OpenShock/Hardware/README.md

# OpenShock-Hardware
KiCAD files for PCBs for transmitters and other hardware for [OpenShock](https://github.com/OpenShock/Firmware)

2024-05-16--23-23-04-kicad
