OpenShock/Hardware/Core v2/Case/STL/Core V2 Half Bottom.stl

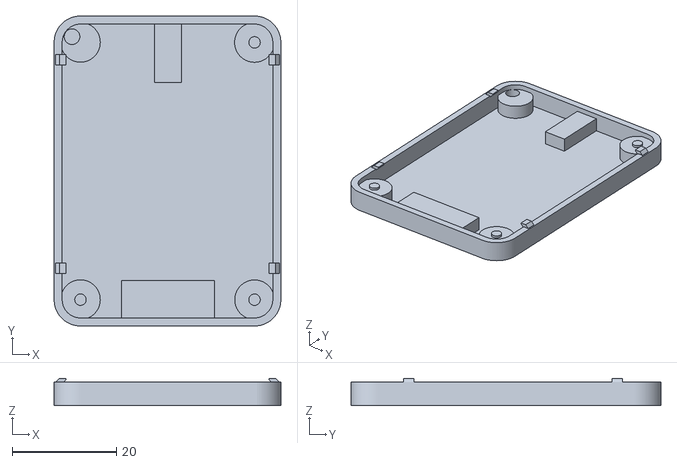
[picture p2: CAD file, 2024-05-17]
Core v2/Case/STL/Core V2 Half Bottom.stl
43.5 x 59.5 x 5.21
