OpenShock/Hardware/Core v2/Case/3MF/Core V2 Top Sans Estop.3mf

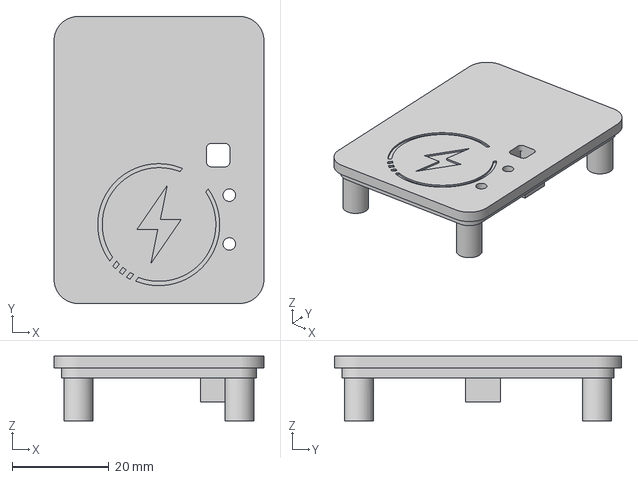
[picture p3: CAD file, 2024-05-17]
Core v2/Case/3MF/Core V2 Top Sans Estop.3mf
43.5 x 59.5 x 13.4 mm
