OpenShock/Hardware/Core v2/Case/3MF/Core V2 EStop.3mf

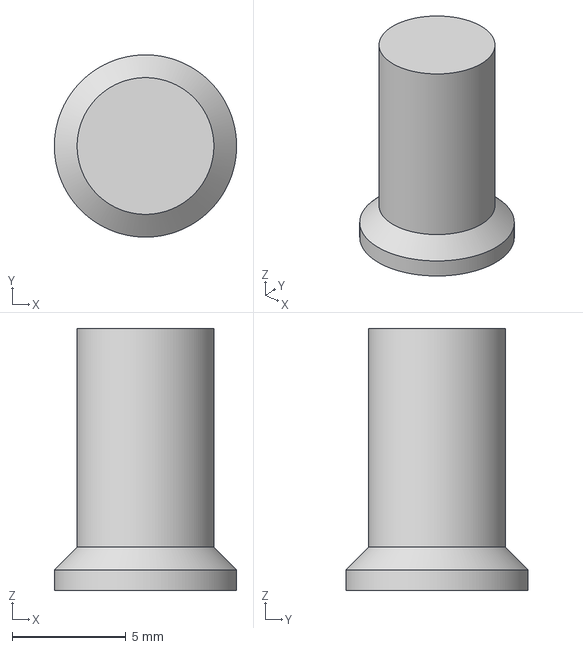
[picture p4: CAD file, 2024-05-17]
Core v2/Case/3MF/Core V2 EStop.3mf
8.00 x 8.00 x 11.5 mm
