OpenShock/Hardware/Core v2/Case/3MF/Core V2 Bottom.3mf

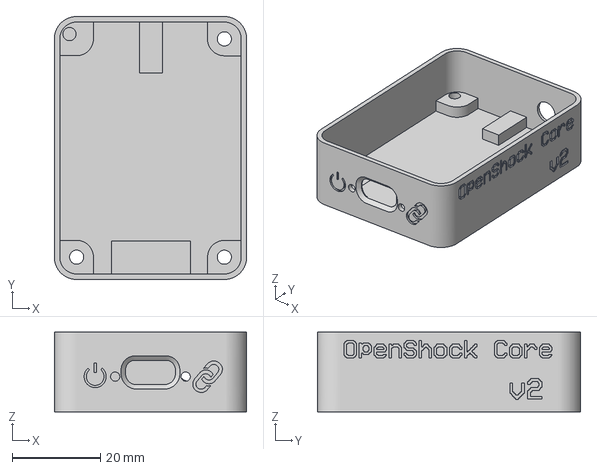
[picture p5: CAD file, 2024-05-17]
Core v2/Case/3MF/Core V2 Bottom.3mf
43.5 x 59.5 x 18.0 mm
