OpenShock/Hardware/Core/Case/3MF/Core V1 Button.3mf

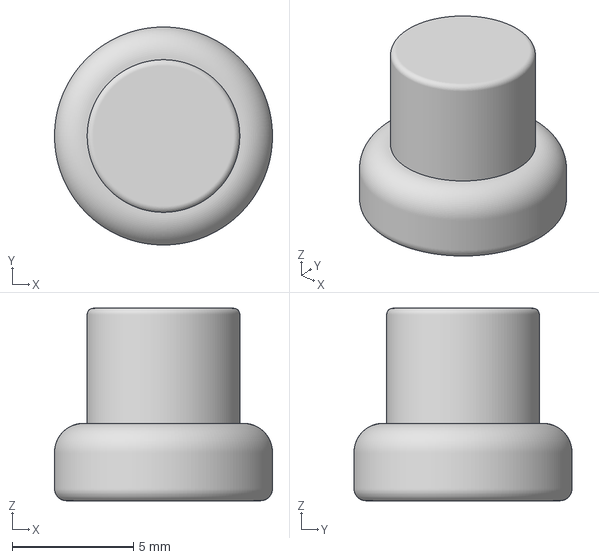
[picture p7: CAD file, 2024-05-17, an earlier design]
Core/Case/3MF/Core V1 Button.3mf
9.00 x 9.00 x 7.95 mm
