OpenShock/Hardware/Core/Case/3MF/Core V1 Top.3mf

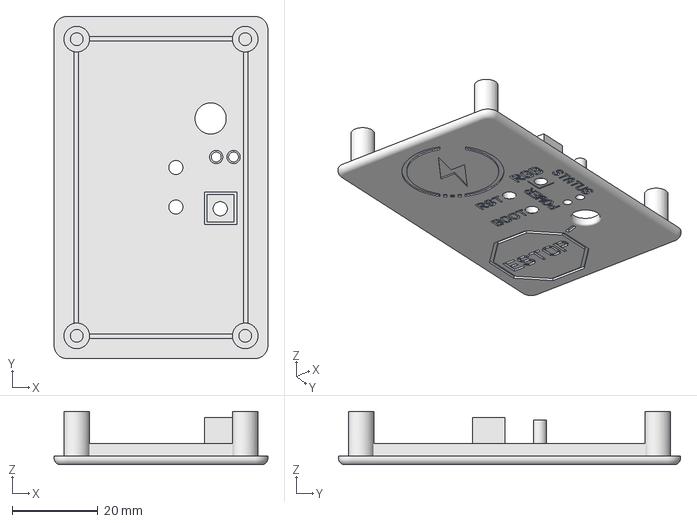
[picture p8: CAD file, 2024-05-17, an earlier design]
Core/Case/3MF/Core V1 Top.3mf
50.0 x 80.0 x 12.5 mm
