OpenShock/Hardware/(list of files, cad)

Other CAD files:
Core v2/Case/3MF/Core V2 Dev Bottom.3mf
Core v2/Case/STL/Core V2 Bottom.stl
Core v2/Case/STL/Core V2 EStop.stl
Core v2/Case/STL/Core V2 Top Sans Estop.stl
Core v2/Case/STL/Core V2 Top.stl
Core/Case/STL/Core V1 Bottom.stl
Core/Case/STL/Core V1 Button.stl
Core/Case/STL/Core V1 Top.stl
