OpenShock/Hardware/Core v2/OpenShock-CoreV2.2-sch.pdf

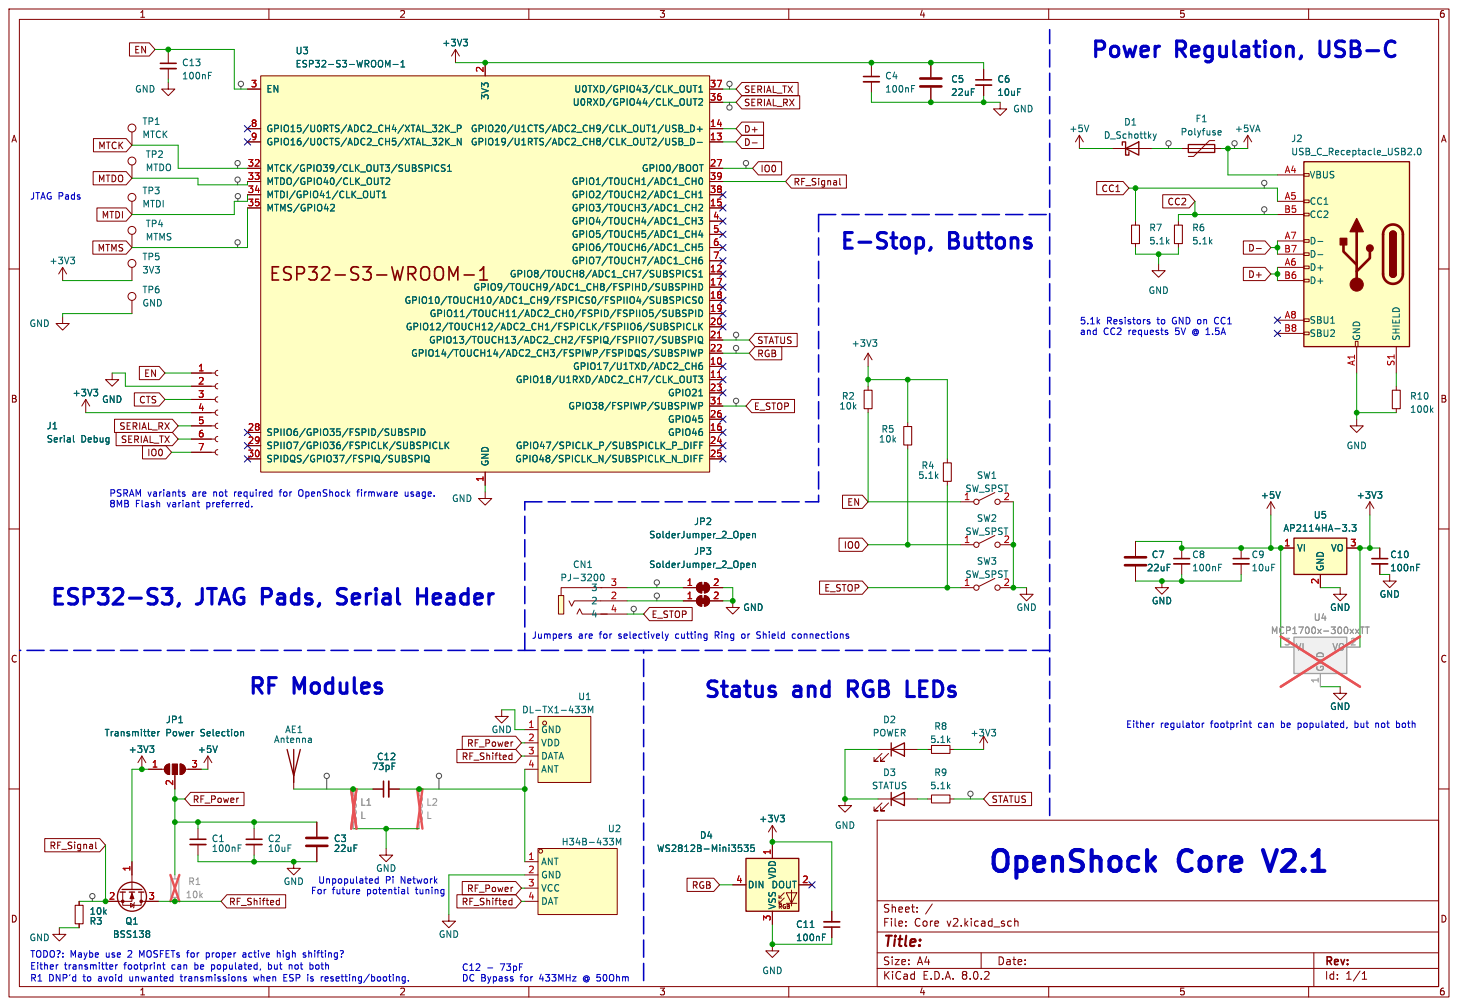
[picture p9: page 1]

2 GPIO12/TOUCH12/ADC2_CH1/FSPICLK/FSPIIO6/SUBSPICLK 20 GPIO13/TOUCH13/ADC2_CH2/FSPIQ/FSPIIO7/SUBSPIQ 21 GPIO14/TOUCH14/ADC2_CH3/FSPIWP/FSPIDQS/SUBSPIWP 22 GPIO21 23 GPIO47/SPICLK_P/SUBSPICLK_P_DIFF 24 GPIO48/SPICLK_N/SUBSPICLK_N_DIFF 25 GPIO45 26 GPIO0/BOOT 27 SPIIO6/GPIO35/FSPID/SUBSPID 28 SPIIO7/GPIO36/FSPICLK/SUBSPICLK 29 EN 3 SPIDQS/GPIO37/FSPIQ/SUBSPIQ 30 GPIO38/FSPIWP/SUBSPIWP 31 MTCK/GPIO39/CLK_OUT3/SUBSPICS1 32 MTDO/GPIO40/CLK_OUT2 33 MTDI/GPIO41/CLK_OUT1 34 MTMS/GPIO42 35 U0RXD/GPIO44/CLK_OUT2 36 U0TXD/GPIO43/CLK_OUT1 37 GPIO2/TOUCH2/ADC1_CH1 38 GPIO1/TOUCH1/ADC1_CH0 39 GPIO4/TOUCH4/ADC1_CH3 4 GPIO5/TOUCH5/ADC1_CH4 5 GPIO6/TOUCH6/ADC1_CH5 6 GPIO7/TOUCH7/ADC1_CH6 7 GPIO15/U0RTS/ADC2_CH4/XTAL_32K_P 8 GPIO16/U0CTS/ADC2_CH5/XTAL_32K_N 9 +3V3

2 GPIO12/TOUCH12/ADC2_CH1/FSPICLK/FSPIIO6/SUBSPICLK 20 GPIO13/TOUCH13/ADC2_CH2/FSPIQ/FSPIIO7/SUBSPIQ 21 GPIO14/TOUCH14/ADC2_CH3/FSPIWP/FSPIDQS/SUBSPIWP 22 GPIO21 23 GPIO47/SPICLK_P/SUBSPICLK_P_DIFF 24 GPIO48/SPICLK_N/SUBSPICLK_N_DIFF 25 GPIO45 26 GPIO0/BOOT 27 SPIIO6/GPIO35/FSPID/SUBSPID 28 SPIIO7/GPIO36/FSPICLK/SUBSPICLK 29 EN 3 SPIDQS/GPIO37/FSPIQ/SUBSPIQ 30 GPIO38/FSPIWP/SUBSPIWP 31 MTCK/GPIO39/CLK_OUT3/SUBSPICS1 32 MTDO/GPIO40/CLK_OUT2 33 MTDI/GPIO41/CLK_OUT1 34 MTMS/GPIO42 35 U0RXD/GPIO44/CLK_OUT2 36 U0TXD/GPIO43/CLK_OUT1 37 GPIO2/TOUCH2/ADC1_CH1 38 GPIO1/TOUCH1/ADC1_CH0 39 GPIO4/TOUCH4/ADC1_CH3 4 GPIO5/TOUCH5/ADC1_CH4 5 GPIO6/TOUCH6/ADC1_CH5 6 GPIO7/TOUCH7/ADC1_CH6 7 GPIO15/U0RTS/ADC2_CH4/XTAL_32K_P 8 GPIO16/U0CTS/ADC2_CH5/XTAL_32K_N 9 U3ESP32-S3-WROOM-1

1 GPIO17/U1TXD/ADC2_CH6 10 GPIO18/U1RXD/ADC2_CH7/CLK_OUT3 11 GPIO8/TOUCH8/ADC1_CH7/SUBSPICS1 12 GPIO19/U1RTS/ADC2_CH8/CLK_OUT2/USB_D- 13 GPIO20/U1CTS/ADC2_CH9/CLK_OUT1/USB_D+ 14 GPIO3/TOUCH3/ADC1_CH2 15 GPIO46 16 GPIO9/TOUCH9/ADC1_CH8/FSPIHD/SUBSPIHD 17 GPIO10/TOUCH10/ADC1_CH9/FSPICS0/FSPIIO4/SUBSPICS0 18 GPIO11/TOUCH11/ADC2_CH0/FSPID/FSPIIO5/SUBSPID 19 3V3

1 VO 2 VI 3 GND GND +3V3

Id: 1/1 Title: File: Core v2.kicad_sch Sheet: /
