OpenShock/Hardware/Core/OpenShock-sch.pdf

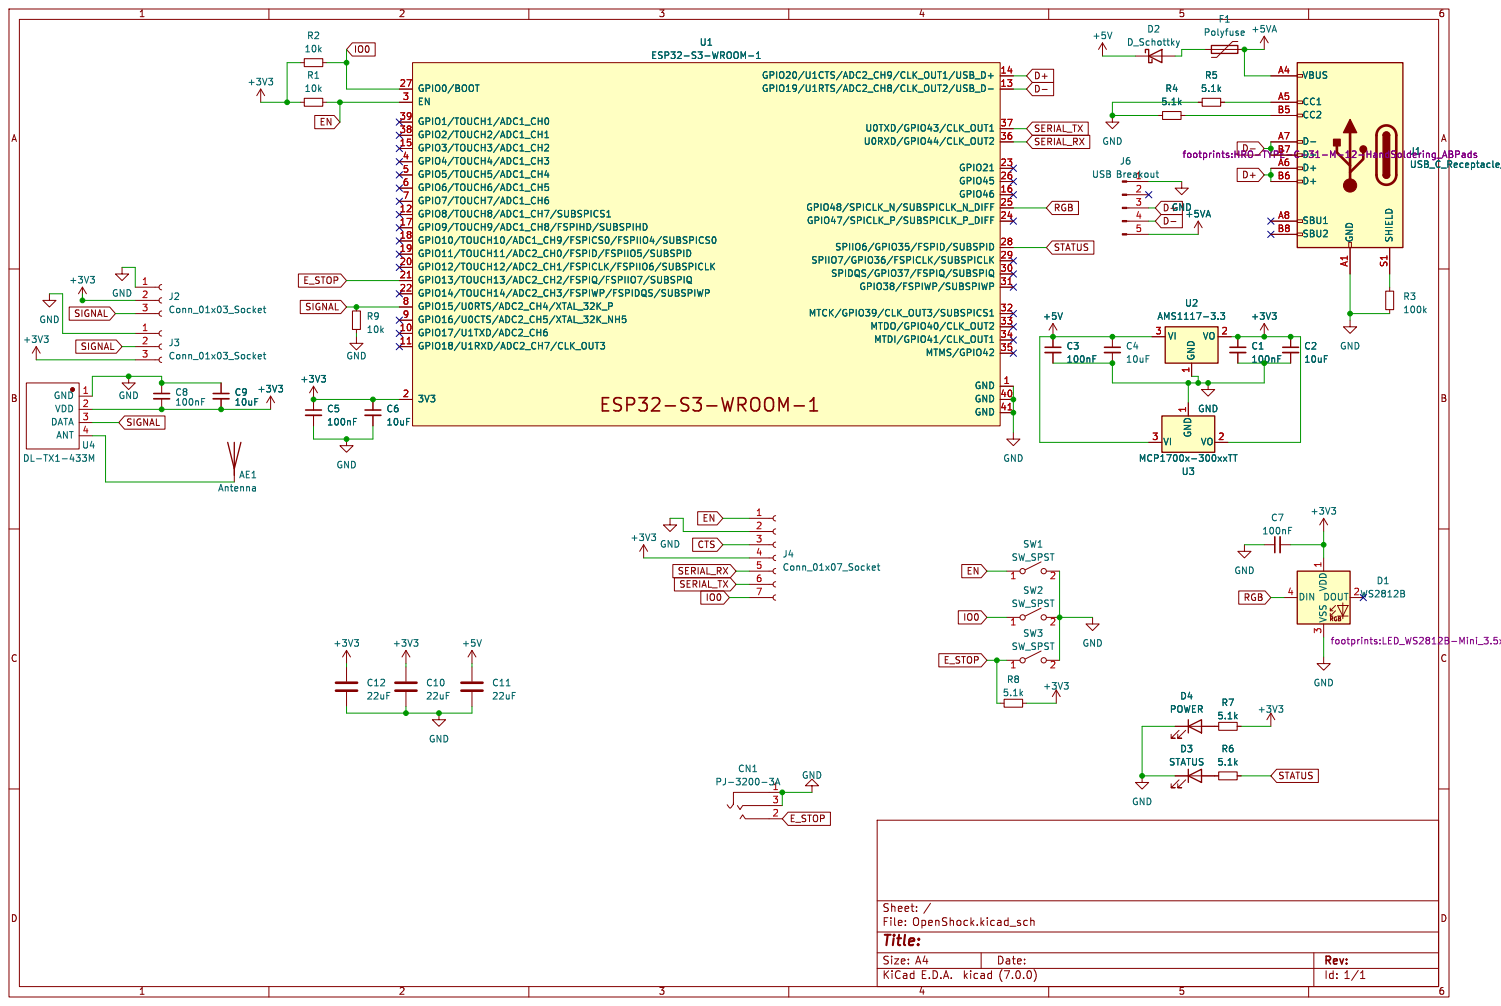
[picture p10: page 1]

Id: 1/1 Title: File: OpenShock.kicad_sch Sheet: / 1
