OpenShock/Hardware/Core v2/Core v2.kicad_pcb

## KiCad design Core v2/Core v2.kicad_pcb (2024-05-17)

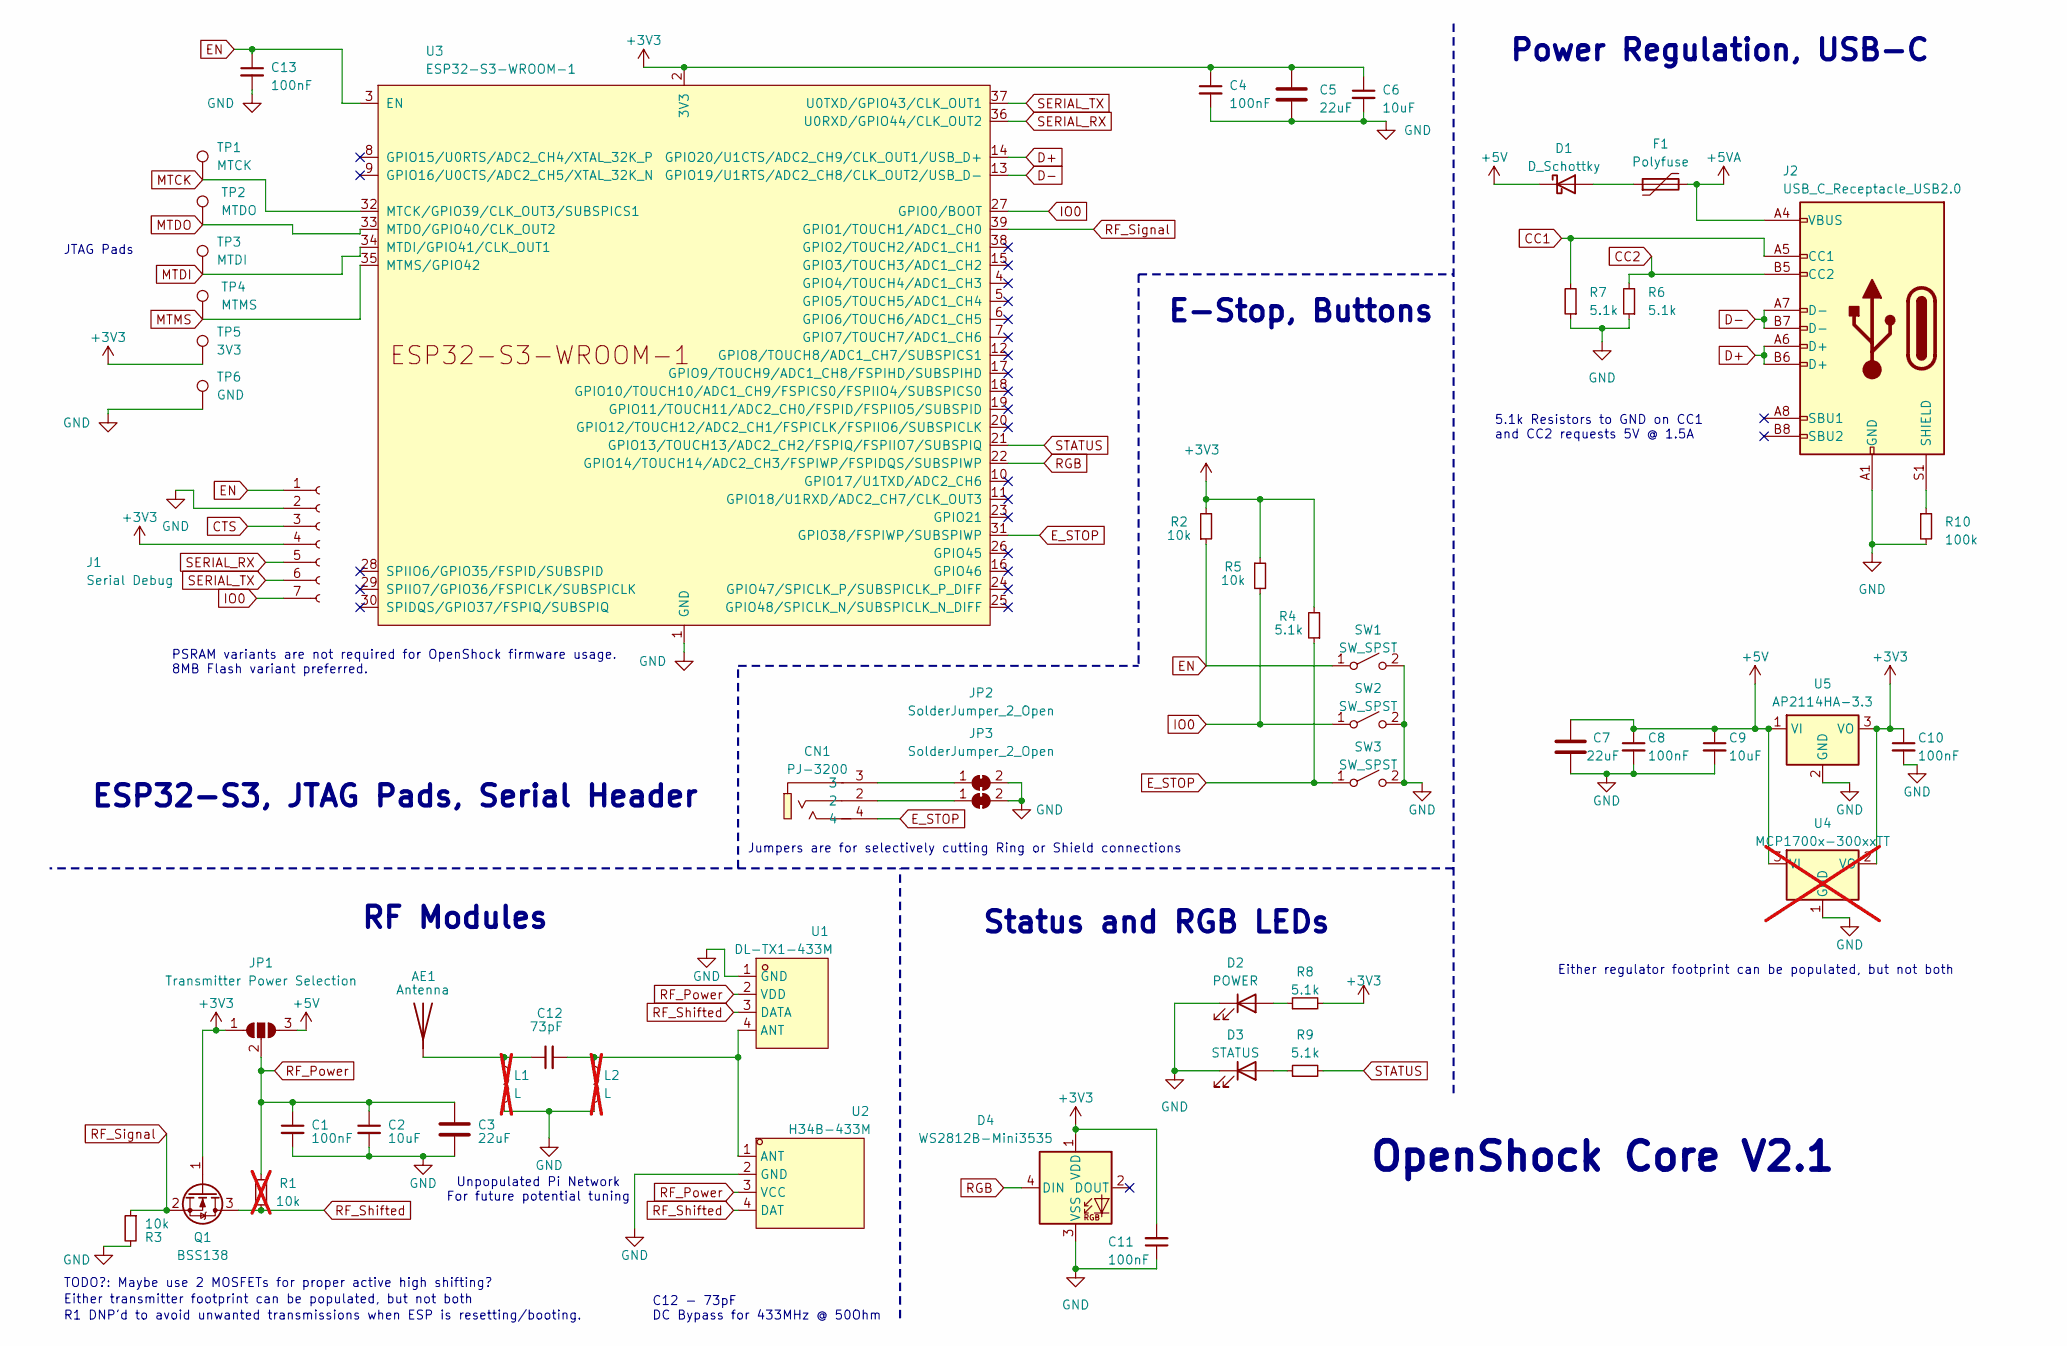
[picture p11: schematic Core v2.kicad_sch]

Parts:
AE1: Antenna; Pin_D1.0mm_L10.0mm
C1, C4, C8, C10, C11, C13: 100nF; C_0603_1608Metric_Pad1.08x0.95mm_HandSolder
C2, C6, C9: 10uF; C_0603_1608Metric_Pad1.08x0.95mm_HandSolder
C3, C5, C7: 22uF; C_0805_2012Metric_Pad1.18x1.45mm_HandSolder
C12: 73pF; C_0603_1608Metric_Pad1.08x0.95mm_HandSolder
CN1: PJ-3200; AUDIO-TH_PJ-3200; LCSC Part C2689690
D1: D_Schottky; D_SOD-123
D2: POWER; LED_0603_1608Metric_Pad1.05x0.95mm_HandSolder
D3: STATUS; LED_0603_1608Metric_Pad1.05x0.95mm_HandSolder
D4: WS2812B-Mini3535; LED_WS2812B-Mini_3.5x3.5mm_P1.75mm
F1: Polyfuse; Fuse_1206_3216Metric_Pad1.42x1.75mm_HandSolder
J1: Serial Debug; 1X07_LOCK
J2: USB_C_Receptacle_USB2.0; HRO-TYPE-C-31-M-12-HandSoldering_ABPads
JP1: Transmitter Power Selection; SolderJumper-3_P1.3mm_Open_RoundedPad1.0x1.5mm
JP2, JP3: SolderJumper_2_Open; SolderJumper-2_P1.3mm_Bridged_RoundedPad1.0x1.5mm
L1, L2: L; L_0603_1608Metric_Pad1.05x0.95mm_HandSolder; not fitted
Q1: BSS138; SOT-23
R1: 10k; R_0603_1608Metric_Pad0.98x0.95mm_HandSolder; not fitted
R2, R3, R5: 10k; R_0603_1608Metric_Pad0.98x0.95mm_HandSolder
R4, R6, R7, R8, R9: 5.1k; R_0603_1608Metric_Pad0.98x0.95mm_HandSolder
R10: 100k; R_0603_1608Metric_Pad0.98x0.95mm_HandSolder
SW1, SW2, SW3: SW_SPST; SW_PUSH_6mm_customized
TP1: MTCK; TestPoint_Pad_1.0x1.0mm
TP2: MTDO; TestPoint_Pad_1.0x1.0mm
TP3: MTDI; TestPoint_Pad_1.0x1.0mm
TP4: MTMS; TestPoint_Pad_1.0x1.0mm
TP5: 3V3; TestPoint_Pad_1.0x1.0mm
TP6: GND; TestPoint_Pad_1.0x1.0mm
U1: DL-TX1-433M; WIELM-TH_DL-TX1-433M; LCSC Part C381160
U2: H34B-433M; WIRELM-TH_H34S-433M; LCSC Part C89460
U3: ESP32-S3-WROOM-1
U4: MCP1700x-300xxTT; SOT-23_Handsoldering; not fitted
U5: AP2114HA-3.3; SOT-223-3_TabPin2

Connections:
+3V3: C4.1, C5.1, C6.1, C10.1, C11.2, D4.1 (VDD), J1.4, JP1.1 (A), Q1.1 (G), R2.2, R4.2, R5.1, R8.2, TP5.1, U3.2 (3V3), U4.2 (VO), U5.3 (VO)
+5V: C7.1, C8.1, C9.1, D1.1 (K), JP1.3 (B), U4.3 (VI), U5.1 (VI)
+5VA: F1.2, J2.A4 (VBUS), J2.A9 (VBUS), J2.B4 (VBUS), J2.B9 (VBUS)
CC1: J2.A5 (CC1), R7.2
CC2: J2.B5 (CC2), R6.2
CTS: J1.3
D+: J2.A6 (D+), J2.B6 (D+), U3.14 (GPIO20/U1CTS/ADC2_CH9/CLK_OUT1/USB_D+)
D-: J2.A7 (D-), J2.B7 (D-), U3.13 (GPIO19/U1RTS/ADC2_CH8/CLK_OUT2/USB_D-)
EN: C13.1, J1.1, R2.1, SW1.1 (A), U3.3 (EN)
E_STOP: CN1.4, R4.1, SW3.1 (A), U3.31 (GPIO38/FSPIWP/SUBSPIWP)
GND: C1.2, C2.2, C3.2, C4.2, C5.2, C6.2, C7.2, C8.2, C9.2, C10.2, C11.1, C13.2, D2.1 (K), D3.1 (K), D4.3 (VSS), J1.2, J2.A1 (GND), J2.A12 (GND), J2.B1 (GND), J2.B12 (GND), JP2.2 (B), JP3.2 (B), L1.2, L2.2, R3.2, R6.1, R7.1, R10.2, SW1.2 (B), SW2.2 (B), SW3.2 (B), TP6.1, U1.1 (GND), U2.2 (GND), U3.1 (GND), U3.40 (GND), U3.41 (GND), U4.1 (GND), U5.2 (GND)
IO0: J1.7, R5.2, SW2.1 (A), U3.27 (GPIO0/BOOT)
MTCK: TP1.1, U3.32 (MTCK/GPIO39/CLK_OUT3/SUBSPICS1)
MTDI: TP3.1, U3.34 (MTDI/GPIO41/CLK_OUT1)
MTDO: TP2.1, U3.33 (MTDO/GPIO40/CLK_OUT2)
MTMS: TP4.1, U3.35 (MTMS/GPIO42)
unnamed: AE1.1 (A), C12.1, L1.1
unnamed: D1.2 (A), F1.1
unnamed: D2.2 (A), R8.1
unnamed: D3.2 (A), R9.1
unnamed: J2.S1 (SHIELD), R10.1
unnamed: CN1.3, JP2.1 (A)
unnamed: CN1.2, JP3.1 (A)
unnamed: C12.2, L2.1, U1.4 (ANT), U2.1 (ANT)
RF_Power: C1.1, C2.1, C3.1, JP1.2 (C), R1.1, U1.2 (VDD), U2.3 (VCC)
RF_Shifted: Q1.3 (D), R1.2, U1.3 (DATA), U2.4 (DAT)
RF_Signal: Q1.2 (S), R3.1, U3.39 (GPIO1/TOUCH1/ADC1_CH0)
RGB: D4.4 (DIN), U3.22 (GPIO14/TOUCH14/ADC2_CH3/FSPIWP/FSPIDQS/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)
SERIAL_RX: J1.5, U3.36 (U0RXD/GPIO44/CLK_OUT2)
SERIAL_TX: J1.6, U3.37 (U0TXD/GPIO43/CLK_OUT1)
STATUS: R9.2, U3.21 (GPIO13/TOUCH13/ADC2_CH2/FSPIQ/FSPIIO7/S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)

Notes on the sheet:
RF Modules
JTAG Pads
PSRAM variants are not required for OpenShock firmware usage. 8MB Flash variant preferred.
OpenShock Core V2.1
E-Stop, Buttons
Power Regulation, USB-C
5.1k Resistors to GND on CC1 and CC2 requests 5V @ 1.5A
Unpopulated Pi Network For future potential tuning
R1 DNP'd to avoid unwanted transmissions when ESP is resetting/booting.
C12 - 73pF DC Bypass for 433MHz @ 50Ohm
Jumpers are for selectively cutting Ring or Shield connections
Status and RGB LEDs
Either transmitter footprint can be populated, but not both
Either regulator footprint can be populated, but not both
TODO?: Maybe use 2 MOSFETs for proper active high shifting?
ESP32-S3, JTAG Pads, Serial Header

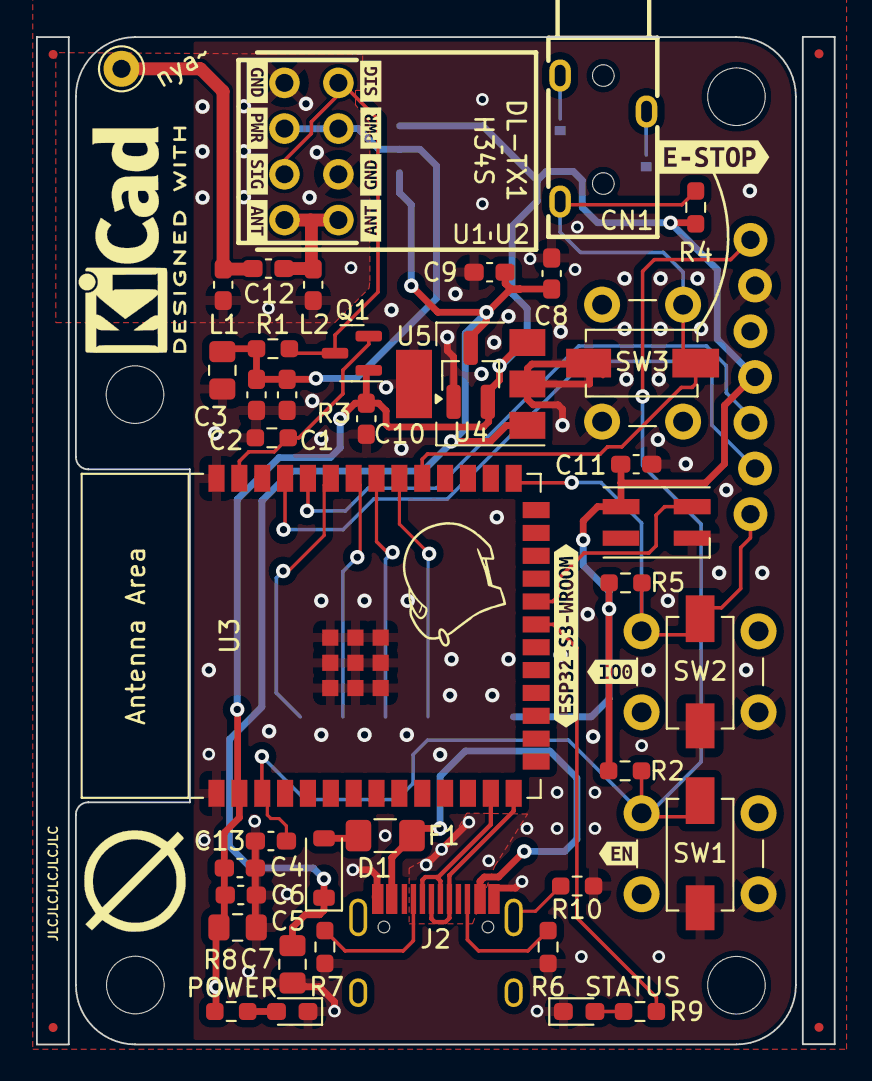
[picture p12: board Core v2.kicad_pcb from above]

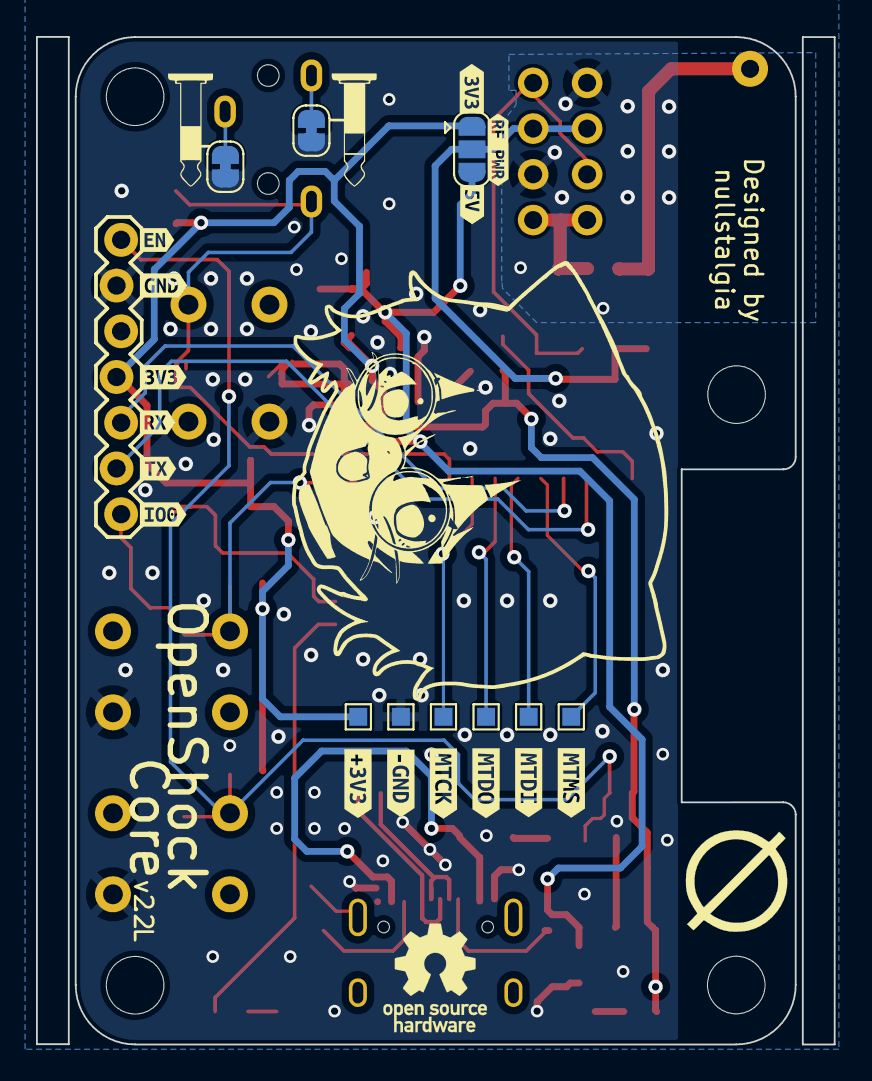
[picture p13: board Core v2.kicad_pcb from below]

Board: 2 copper layers, 40.0 x 56.0 mm, 83 parts (25 on the bottom side), 30 nets.

Other parts of the board:
FID1, FID1#2, FID4, FID4#2: Fiducial; Fiducial_0.5mm_Mask1mm
kibuzzard-63FC1B9A: G***; kibuzzard-63FC1B9A
kibuzzard-63FC1BA4: G***; kibuzzard-63FC1BA4
kibuzzard-63FC1BB3: G***; kibuzzard-63FC1BB3
kibuzzard-65FD518D: G***; kibuzzard-65FD518D
kibuzzard-65FD5191: G***; kibuzzard-65FD5191
kibuzzard-658A25BD: G***; kibuzzard-658A25BD
kibuzzard-658A26D4: G***; kibuzzard-658A26D4
kibuzzard-658A26D7: G***; kibuzzard-658A26D7
kibuzzard-658A26DB: G***; kibuzzard-658A26DB
kibuzzard-658A27EA: G***; kibuzzard-658A27EA
kibuzzard-658A42A3, kibuzzard-658A42A3#2: G***; kibuzzard-658A42A3
kibuzzard-658A42A8, kibuzzard-658A42A8#2: G***; kibuzzard-658A42A8
kibuzzard-658A42AC, kibuzzard-658A42AC#2: G***; kibuzzard-658A42AC
kibuzzard-658A264C: G***; kibuzzard-658A264C
kibuzzard-658A265D: G***; kibuzzard-658A265D
kibuzzard-658A269D: G***; kibuzzard-658A269D
kibuzzard-658A429F, kibuzzard-658A429F#2: G***; kibuzzard-658A429F
kibuzzard-658A779F: G***; kibuzzard-658A779F
kibuzzard-658A2647: G***; kibuzzard-658A2647
kibuzzard-658A2652: G***; kibuzzard-658A2652
kibuzzard-658A2659: G***; kibuzzard-658A2659
kibuzzard-658A2661: G***; kibuzzard-658A2661
kibuzzard-658A4835: G***; kibuzzard-658A4835
