OpenShock/Hardware/Core/OpenShock.kicad_pcb

## KiCad design Core/OpenShock.kicad_pcb (2023-12-02, an earlier design)

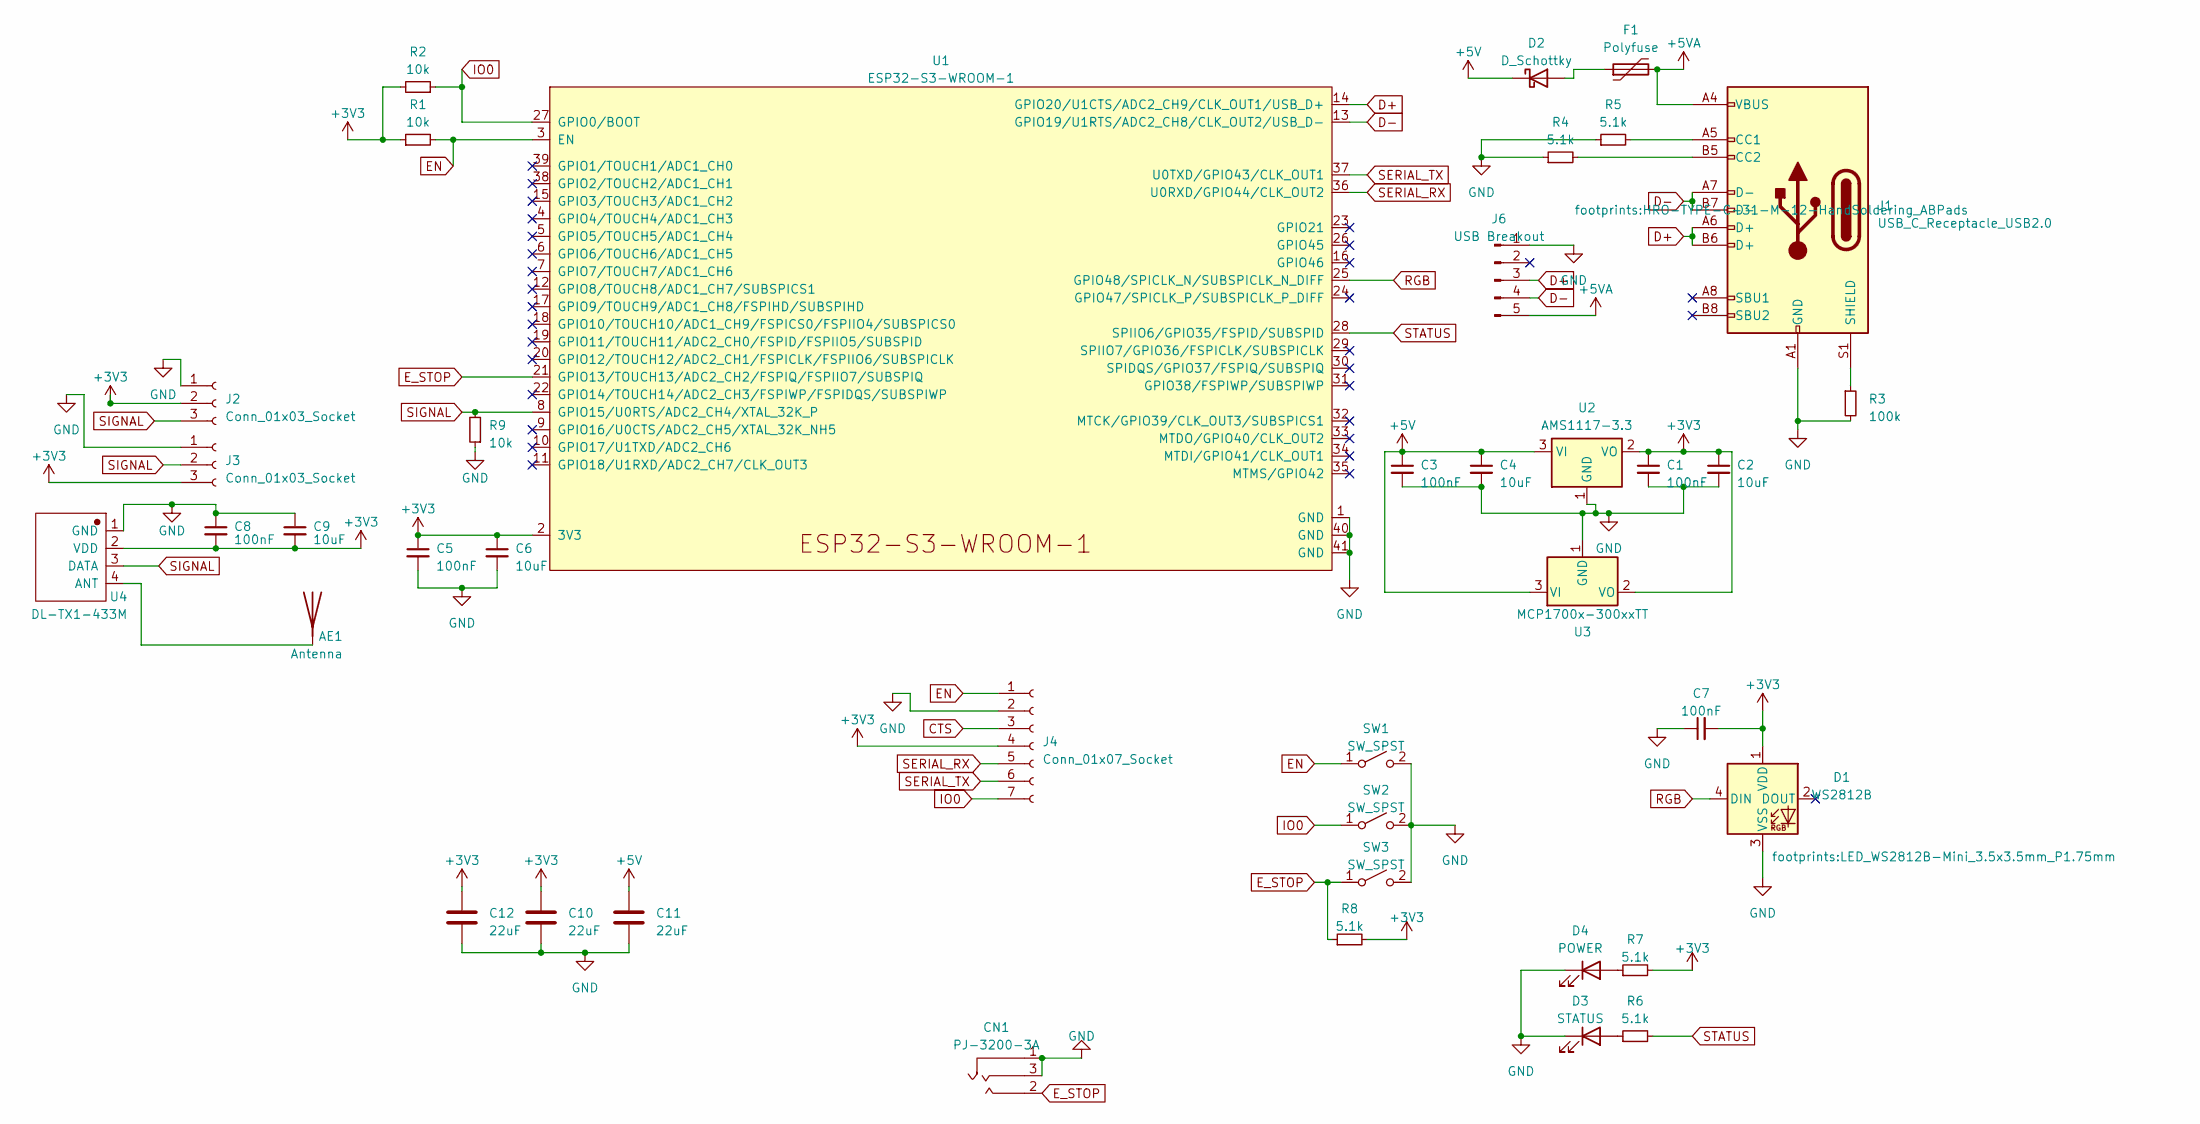
[picture p14: schematic OpenShock.kicad_sch]

Parts:
AE1: Antenna; PinHeader_1x01_P2.54mm_Vertical
C1, C3, C5, C7, C8: 100nF; C_0603_1608Metric_Pad1.08x0.95mm_HandSolder
C2, C4, C6, C9: 10uF; C_0603_1608Metric_Pad1.08x0.95mm_HandSolder
C10, C11, C12: 22uF; C_0805_2012Metric_Pad1.18x1.45mm_HandSolder
CN1: PJ-3200-3A; AUDIO-TH_PJ-3200-3A
D1: WS2812B; LED_WS2812B-Mini_3.5x3.5mm_P1.75mm
D2: D_Schottky; D_SOD-123
D3: STATUS; LED_0603_1608Metric_Pad1.05x0.95mm_HandSolder
D4: POWER; LED_0603_1608Metric_Pad1.05x0.95mm_HandSolder
F1: Polyfuse; Fuse_1206_3216Metric_Pad1.42x1.75mm_HandSolder
J1: USB_C_Receptacle_USB2.0; HRO-TYPE-C-31-M-12-HandSoldering_ABPads
J2, J3: Conn_01x03_Socket; PinSocket_1x03_P2.54mm_Vertical
J4: Conn_01x07_Socket; 1X07_LOCK
J6: USB Breakout; PinSocket_1x05_P2.54mm_Vertical
R1, R2, R9: 10k; R_0603_1608Metric_Pad0.98x0.95mm_HandSolder
R3: 100k; R_0603_1608Metric_Pad0.98x0.95mm_HandSolder
R4, R5, R6, R7, R8: 5.1k; R_0603_1608Metric_Pad0.98x0.95mm_HandSolder
SW1, SW2: SW_SPST; SW_PUSH_6mm_customized
SW3: SW_SPST; SW_PUSH-12mm
U1: ESP32-S3-WROOM-1
U2: AMS1117-3.3; SOT-223-3_TabPin2
U3: MCP1700x-300xxTT; SOT-23_Handsoldering
U4: DL-TX1-433M; WIELM-TH_DL-TX1-433M

Connections:
+3V3: C1.1, C2.1, C5.1, C6.1, C7.2, C8.2, C9.2, C10.1, C12.1, D1.1 (VDD), J2.2, J3.3, J4.4, R1.1, R2.2, R7.2, R8.2, U1.2 (3V3), U2.2 (VO), U3.2 (VO), U4.2 (VDD)
+5V: C3.1, C4.1, C11.1, D2.1 (K), U2.3 (VI), U3.3 (VI)
+5VA: F1.2, J1.A4 (VBUS), J1.A9 (VBUS), J1.B4 (VBUS), J1.B9 (VBUS), J6.5
CTS: J4.3
D+: J1.A6 (D+), J1.B6 (D+), J6.3, U1.14 (GPIO20/U1CTS/ADC2_CH9/CLK_OUT1/USB_D+)
D-: J1.A7 (D-), J1.B7 (D-), J6.4, U1.13 (GPIO19/U1RTS/ADC2_CH8/CLK_OUT2/USB_D-)
EN: J4.1, R1.2, SW1.1 (A), U1.3 (EN)
E_STOP: CN1.2, R8.1, SW3.1 (A), U1.21 (GPIO13/TOUCH13/ADC2_CH2/FSPIQ/FSPIIO7/S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)
GND: C1.2, C2.2, C3.2, C4.2, C5.2, C6.2, C7.1, C8.1, C9.1, C10.2, C11.2, C12.2, CN1.1, CN1.3, D1.3 (VSS), D3.1 (K), D4.1 (K), J1.A1 (GND), J1.A12 (GND), J1.B1 (GND), J1.B12 (GND), J2.1, J3.1, J4.2, J6.1, R3.2, R4.1, R5.1, R9.1, SW1.2 (B), SW2.2 (B), SW3.2 (B), U1.1 (GND), U1.40 (GND), U1.41 (GND), U2.1 (GND), U3.1 (GND), U4.1 (GND)
IO0: J4.7, R2.1, SW2.1 (A), U1.27 (GPIO0/BOOT)
unnamed: AE1.1 (A), U4.4 (ANT)
unnamed: D2.2 (A), F1.1
unnamed: D3.2 (A), R6.1
unnamed: D4.2 (A), R7.1
unnamed: J1.A5 (CC1), R5.2
unnamed: J1.B5 (CC2), R4.2
unnamed: J1.S1 (SHIELD), R3.1
RGB: D1.4 (DIN), U1.25 (GPIO48/SPICLK_N/SUBSPICLK_N_DIFF)
SERIAL_RX: J4.5, U1.36 (U0RXD/GPIO44/CLK_OUT2)
SERIAL_TX: J4.6, U1.37 (U0TXD/GPIO43/CLK_OUT1)
SIGNAL: J2.3, J3.2, R9.2, U1.8 (GPIO15/U0RTS/ADC2_CH4/XTAL_32K_P), U4.3 (DATA)
STATUS: R6.2, U1.28 (SPIIO6/GPIO35/FSPID/SUBSPID)

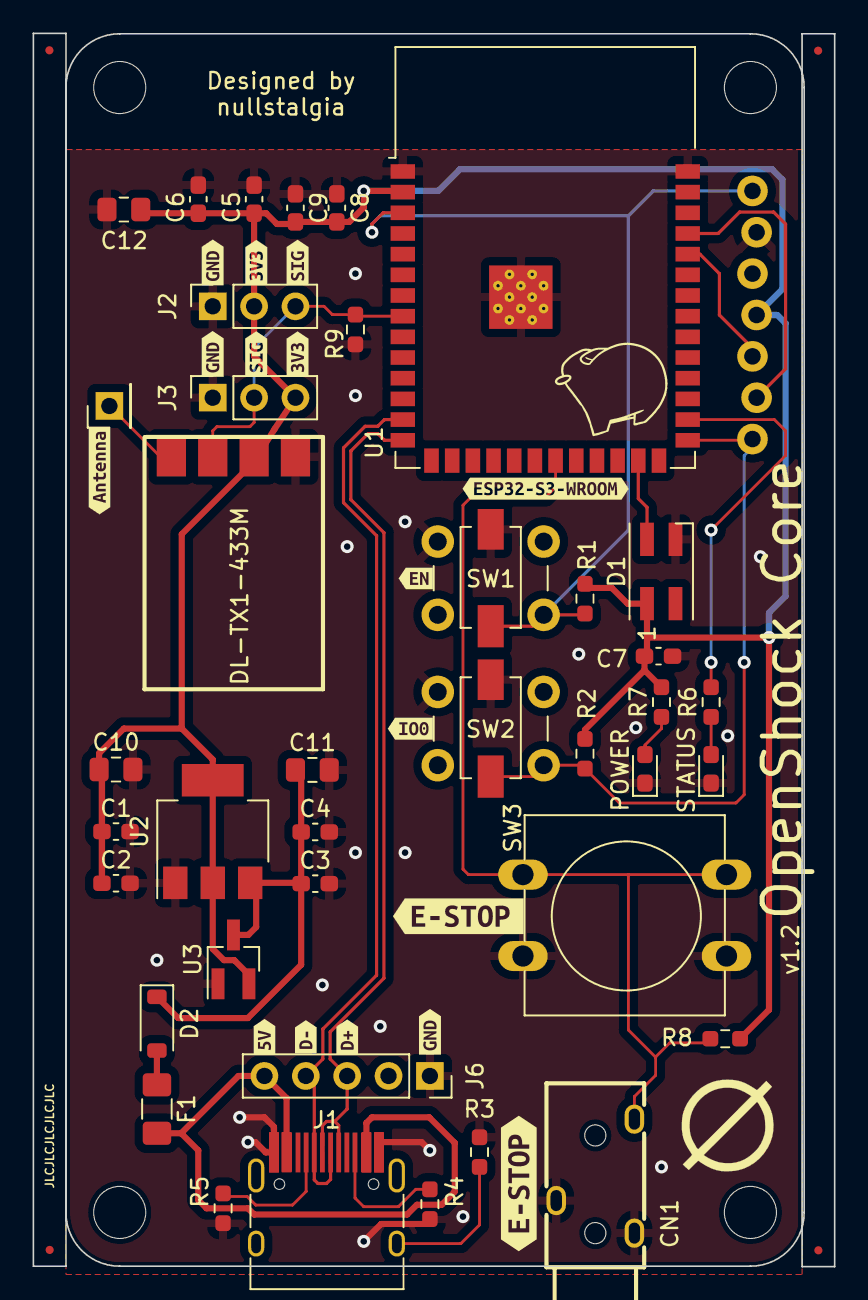
[picture p15: board OpenShock.kicad_pcb from above]

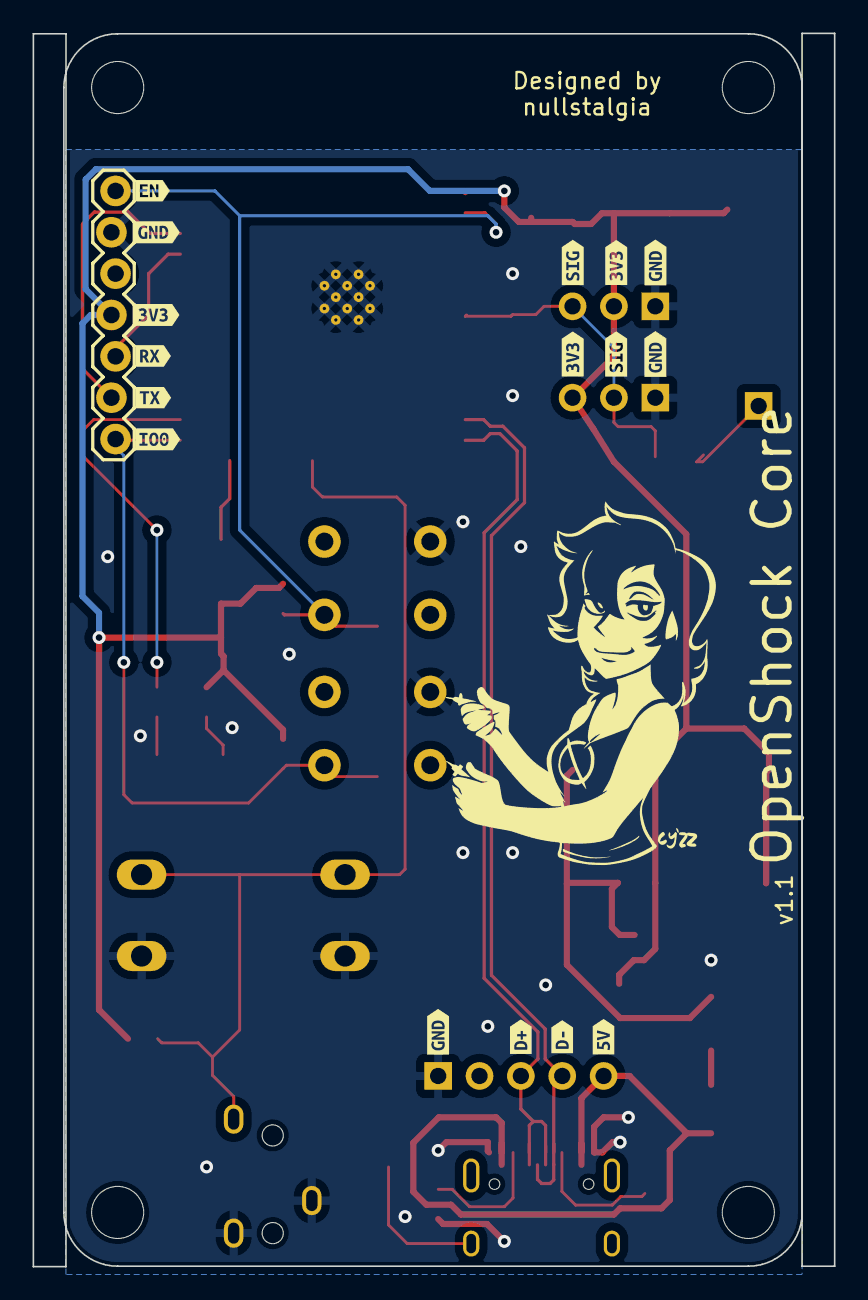
[picture p16: board OpenShock.kicad_pcb from below]

Board: 2 copper layers, 49.2 x 75.7 mm, 75 parts (17 on the bottom side), 21 nets.

Other parts of the board:
FID1, FID4, FID4#2: Fiducial; Fiducial_0.5mm_Mask1mm
kibuzzard-63FC1A6B, kibuzzard-63FC1A6B#2: G***; kibuzzard-63FC1A6B
kibuzzard-63FC1B9A: G***; kibuzzard-63FC1B9A
kibuzzard-63FC1BA4: G***; kibuzzard-63FC1BA4
kibuzzard-63FC1BB3: G***; kibuzzard-63FC1BB3
kibuzzard-63FC1BEB: G***; kibuzzard-63FC1BEB
kibuzzard-63FC2C9B: G***; kibuzzard-63FC2C9B
kibuzzard-63FC2CA9: G***; kibuzzard-63FC2CA9
kibuzzard-63FC2CB3: G***; kibuzzard-63FC2CB3
kibuzzard-63FC2CBA: G***; kibuzzard-63FC2CBA
kibuzzard-63FC2CC3: G***; kibuzzard-63FC2CC3
kibuzzard-63FC2CD0: G***; kibuzzard-63FC2CD0
kibuzzard-63FC15BA: G***; kibuzzard-63FC15BA
kibuzzard-63FC17E4, kibuzzard-63FC17E4#2: G***; kibuzzard-63FC17E4
kibuzzard-63FC17F2, kibuzzard-63FC17F2#2: G***; kibuzzard-63FC17F2
kibuzzard-63FC17FB, kibuzzard-63FC17FB#2: G***; kibuzzard-63FC17FB
kibuzzard-63FC19D3, kibuzzard-63FC19D3#2: G***; kibuzzard-63FC19D3
kibuzzard-63FC180E, kibuzzard-63FC180E#2: G***; kibuzzard-63FC180E
kibuzzard-63FC195C, kibuzzard-63FC195C#2, kibuzzard-63FC195C#3, kibuzzard-63FC195C#4: G***; kibuzzard-63FC195C
kibuzzard-63FC1570: G***; kibuzzard-63FC1570
kibuzzard-63FC1972, kibuzzard-63FC1972#2: G***; kibuzzard-63FC1972
kibuzzard-63FC1979, kibuzzard-63FC1979#2: G***; kibuzzard-63FC1979
