OpenShock/Hardware/(commit log)

2023-04-06 Core v1.1
    [OpenShock-CuBottom.gbr, OpenShock-CuTop.gbr, OpenShock-EdgeCuts.gbr, OpenShock-MaskBottom.gbr, OpenShock-MaskTop.gbr, OpenShock-NPTH.drl, OpenShock-PTH.drl, OpenShock-PasteBottom.gbr]
2023-07-17 Add schematic PDF and pics
2023-08-24 .gitignore was hiding exported BOM + PNP for JLC ordering
    [BOM-OpenShock.csv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]
2023-12-02 OpenShock Core V1.2, fixes dumb short between 3v3 and GND
    [BOM-OpenShock.csv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]
2024-01-28 Core V2!
    [BOM-OpenShock-rounded.csv, Core v2-rounded.kicad_pcb, Core v2.kicad_pcb, Core v2.kicad_sch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]
2024-03-31 Remove R1 from Core V2.0 BOM/CPL
    [BOM-OpenShock-rounded.csv, Core v2.kicad_sch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]
2024-05-17 Core V2.1 KiCad + JLC Files
    [BOM-Core v2-rounded.csv, Core v2-rounded.kicad_pcb, Core v2.kicad_pcb, Core v2.kicad_sch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]
2024-05-17 Core V2.2 KiCad + JLC Files
    [BOM-Core v2-rounded.csv, Core v2-rounded.kicad_pcb, Core v2.kicad_pcb, Core v2.kicad_sch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]
2024-05-17 Core V1 and V2 case files (3MF, STL, STEP)
    [Core V1 Bottom.3mf, Core V1 Bottom.stl, Core V1 Button.3mf, Core V1 Button.stl, Core V1 Top.3mf, Core V1 Top.stl, Core V2 Bottom.3mf, Core V2 Bottom.stl]
